bennowotny/ECE453_DumptruckUltra/ECE453_DumptruckUltra_Board/PCBFAB/README.txt

The board outline is defined by a 10 mil trace found on all gerbers.

The board is 4 in x 6 in.
