bennowotny/ECE453_DumptruckUltra/ECE453_DumptruckUltra_Board/Project Outputs for ECE453_DumptruckUltra_Board/ECE453_DumptruckUltra_Board.xlsx

Line # | Name | Description | Designator | Revision ID | Revision State | Revision Status | Quantity | Manufacturer 1 | Manufacturer Part Number 1 | Manufacturer Lifecycle 1 | Supplier 1 | Supplier Part Number 1 | Supplier Unit Price 1 | Supplier Subtotal 1 | Column1
 | 0.1uF | CAP CER 0.1UF 25V X7R 0805 | C1, C2, C5, C6, C9, C10, C17, C25, C40 |  | Unknown server |  | 9 | Kyocera AVX | 08053C104KAT2A | Volume Production | Digi-Key | 478-3755-1-ND | 0.061 | 0.61
 | 2.2uF | Cap Ceramic 2.2uF 35V X7R 10% Pad SMD 0805 +125°C Automotive T/R | C11, C12, C18 |  | Unknown server |  | 3 | TDK | CGA4J1X7R1V225K125AC | Volume Production | Digi-Key | 445-6963-1-ND | 0.42 | 1.26
 | 22uF | Chip Multilayer Ceramic Capacitors for General Purpose, 0805, 22uF, X5R, 15%, 20%, 25V | C13, C14, C15, C16, C19, C20 |  | Unknown server |  | 6 | Murata | GRM21BR61E226ME44L | Volume Production | Digi-Key | 490-10749-1-ND | 0.36 | 2.16
 | 1000uF | Aluminum Electrolytic Capacitor, UD Series, Low Impedance, 1000 uF, 10 V, + / - 20%, -55 to 105 degC, Chip Type, 10 x 10 mm D x L, Pb-Free, Reel | C21, C22, C23, C29, C30 |  | Unknown server |  | 5 | Nichicon | UUD1A102MNL1GS | Volume Production | Digi-Key | 493-2254-1-ND | 0.94 | 4.7
 | 6pF |  | C27, C28 |  | Unknown server |  | 2 | Kyocera AVX | 08055A6R0CAT2A | Volume Production | Digi-Key | 478-11894-1-ND | 0.24 | 0.48
 | 1uF |  | C3, C4, C7, C8, C26, C41 |  | Unknown server |  | 6 | Yageo | CC0805ZRY5V8BB105 | Volume Production | Digi-Key | 311-1358-1-ND | 0.13 | 0.78
 | BAR43CFILM | DIODE ARRAY SCHOTTKY 30V SOT23-3 | D1 |  | Unknown server |  | 1 | STMicroelectronics | BAR43CFILM | Volume Production | Digi-Key | 497-2520-1-ND | 0.42 | 0.42
 | HSMG-C170 | Chip LED, Green, 2.2 V, -40 to 85 degC, 2-Pin SMD, Pb-Free, Tape and Reel | DS1, DS2, DS3, DS4, DS5, DS6, DS7, DS8, DS9, DS10, DS11, DS12 |  | Unknown server |  | 12 | Broadcom Avago | HSMG-C170 | Volume Production | Digi-Key | 516-1434-1-ND | 0.251 | 3.01
 | 1729128 | PCB Terminal Block, 13.5 A, 400 V, 2-Pin THD, RoHS, Bulk | J1, J2 |  | Unknown server |  | 2 | Phoenix Contact | 1729128 | Volume Production | Digi-Key | 277-1247-ND | 1.17 | 2.34
 | KLDX-0202-A | DC Power Jack, 24 V, 3.5 A, -25 to 85 degC, 3-Pin THD, RoHS | J10 |  | Unknown server |  | 1 | Kycon | KLDX-0202-A | Volume Production | Digi-Key | 2092-KLDX-0202-A-ND | 0.74 | 0.74
 | PPTC052LFBN-RC | Receptacle, Pitch 2.54 mm, 2 x 5 Position, Height 8.5 mm, Tail Length 3.2 mm, -40 to 105 degC, RoHS | J11 |  | Unknown server |  | 1 | Sullins | PPTC052LFBN-RC | Volume Production | Digi-Key | S6105-ND | 0.69 | 0.69
 | ShuntHeader | Conn Mini Shunt 2 POS 2.54mm Black Cable Mount | J12, J14, J15, J16, J17, J18, J19, J20 |  | Not managed |  | 8 | Kycon | SX1100-B | Volume Production | Digi-Key | 2092-SX1100-B-ND | 0.06 | 0.6
 |  | Female, 6C, Rt Angle, .100"CC; 3.15mm Tail, No Mounting; PBT, Phos. Bronze, 105 C | J201 |  | Not managed |  | 1 | Sullins | PPPC061LGBN-RC | Volume Production | Digi-Key | S5481-ND | 0.66 | 0.66
 | 951103-8622-AR | CONN HEADER VERT 3POS 2MM | J3, J4, J5, J6, J7, J8, J9 |  | Unknown server |  | 7 | 3M | 951103-8622-AR | Volume Production | Digi-Key | 3M156413-03-ND | 0.3 | 2.1
 | 12uH | SDR0403 Series Power Inductor, 12 uF +/- 20 %, 0.21 Ohm, -40 to 125 degC, 2-Pin SMD, RoHS, Tape and Reel | L1 |  | Unknown server |  | 1 | Bourns | SDR0403-120ML | Volume Production | Digi-Key | SDR0403-120MLCT-ND | 0.62 | 0.62
 | 8.2uH | FIXED IND 8.2UH 2A 180 MOHM SMD | L2 |  | Unknown server |  | 1 | Bourns | SRP4020TA-8R2M | Volume Production | Digi-Key | SRP4020TA-8R2MCT-ND | 1.35 | 1.35
 | 10uH | SMD Inductors 10uH ±10% 0.15A 0.468O 0805 | L3 |  | Unknown server |  | 1 | Taiyo Yuden | LBR2012T100K | Not Recommended for New Design | Digi-Key | 587-2045-1-ND | 0.13 | 0.13
 | CYBLE-416045-02 | RF TXRX MOD BLUETOOTH TRACE ANT | MD1 |  | Unknown server |  | 1 | Cypress | CYBLE-416045-02
 | 61300211121 | THT Vertical Pin Header WR-PHD, Pitch 2.54 mm, Single Row, 2 pins | P1, P3, P4, P5, P6, P8, P9, P10, P11 |  | Unknown server |  | 9 | Wurth Electronics | 61300211121 | Volume Production | Digi-Key | 732-5315-ND | 0.113 | 1.13
 | 61300511121 | THT Vertical Pin Header WR-PHD, Pitch 2.54 mm, Single Row, 5 pins | P2 |  | Unknown server |  | 1 | Wurth Electronics | 61300511121 | Volume Production | Digi-Key | 732-5318-ND | 0.26 | 0.26
 | 61300611021 | THT Angled Pin Header WR-PHD, Pitch 2.54 mm, Single Row, 6 pins | P7 |  | Unknown server |  | 1 | Wurth Electronics | 61300611021 | Volume Production | Digi-Key | 732-5339-ND | 0.57 | 0.57
 | BSS138W-7-F | N-Channel Enhancement Mode Mosfet, 50 V, 200 mA, -55 to 150 degC, 6-Pin SOT-323, RoHS, Tape and Reel | Q1, Q2, Q3, Q4, Q5, Q6, Q7 |  | Unknown server |  | 7 | Diodes | BSS138W-7-F | Volume Production | Digi-Key | BSS138W-FDICT-ND | 0.31 | 2.17
 | FDC653N | MOSFET N-CH 30V 5A SSOT-6 | Q8 |  | Unknown server |  | 1 | ON Semiconductor / Fairchild | FDC653N | Volume Production | Digi-Key | FDC653NCT-ND | 0.66 | 0.66
 | 1k | RES 1K OHM 0.1% 1/8W 0805 | R1, R3 |  | Unknown server |  | 2 | Panasonic | ERA6AEB102V | Volume Production
 | 200k |  | R10 |  | Unknown server |  | 1 | Vishay | CRCW0805200KFKEA | Volume Production | Digi-Key | 541-200KCCT-ND | 0.1 | 0.1
 | 22.1k |  | R11, R18 |  | Unknown server |  | 2 | Panasonic | ERJ-6ENF2212V | Volume Production | Digi-Key | P22.1KCCT-ND | 0.1 | 0.2
 | 330, CRCW0805330RFKEA | RES Thick Film, 330O, 1%, 0.125W, 100ppm/°C, 0805 | R12, R13, R23, R24, R25, R29, R61, R65, R66, R67, R69 |  | Unknown server |  | 11 | Vishay | CRCW0805330RFKEA | Volume Production | Digi-Key, [NoParam] | 541-330CCT-ND, [NoParam]
 | 100k | RES 100K OHM 1% 1/8W 0805 | R16, R19 |  | Unknown server |  | 2 | Yageo | RC0805FR-07100KL | Volume Production | Digi-Key | 311-100KCRCT-ND | 0.1 | 0.2
 | ERJ-6GEYJ911V |  | R17 |  | Unknown server |  | 1 | Panasonic | ERJ-6GEYJ911V | Volume Production | Digi-Key | P910ACT-ND | 0.1 | 0.1
 | 10k | Chip Resistor, 10 KOhm, +/- 1%, 0.125 W, -55 to 155 degC, 0805 (2012 Metric), RoHS, Tape and Reel | R2, R4, R5, R6, R7, R8, R9, R14, R15, R28, R39, R58 |  | Unknown server |  | 12 | Yageo | RC0805FR-0710KL | Volume Production | Digi-Key | 311-10.0KCRCT-ND | 0.027 | 0.324
 | 330Ohms | Res Thick Film 0805 300O 5% 0.125W ±200ppm/°C Automotive Paper T/R | R20, R27, R57 |  | Unknown server |  | 3 | Rohm | KTR10EZPJ301 | Volume Production | Digi-Key | RHM300BCT-ND | 0.17 | 0.51
 | 13.7k | RES Thick Film, 13.7kO, 1%, 0.125W, 100ppm/°C, 0805 | R21 |  | Unknown server |  | 1 | Vishay | CRCW080513K7FKEA | Volume Production | Digi-Key | 541-13.7KCCT-ND | 0.1 | 0.1
 | CRCW0805110RFKEA |  | R22 |  | Unknown server |  | 1 | Vishay | CRCW0805110RFKEA | Volume Production | Digi-Key | 541-110CCT-ND | 0.1 | 0.1
 | 100Ohms | Chip Resistor, 100 Ohm, +/-1%, 0.125 W, -55 to 155 degC, 0805 (2012 Metric), RoHS, Tape and Reel | R30, R31, R32, R33, R34, R35, R36, R37, R38, R41, R42, R43, R44, R45, R46, R47, R48, R49, R50, R51, R52, R53, R54, R55, R56 |  | Unknown server |  | 25 | Yageo | RC0805FR-07100RL | Volume Production | Digi-Key | 311-100CRCT-ND | 0.025 | 0.625
 | 100k | RES 100K OHM 0.1% 1/8W 0805 | R40 |  | Unknown server |  | 1 | Panasonic | ERA-6AEB104V | Volume Production | Digi-Key | P100KDACT-ND | 0.36 | 0.36
 | 0 ohm | Chip Resistor, 0 Ohm, +/- 1%, 0.125 W, -55 to 155 degC, 0805 (2012 Metric), RoHS, Tape and Reel | R68, R70 |  | Unknown server |  | 2 | Panasonic | ERJ-6GEY0R00V | Volume Production | Digi-Key | P0.0ACT-ND | 0.1 | 0.2
 | 150141M173100 | SMD Full-Color Top LED, WL-SFTW, Red & Green & Blue | RGBLED0 |  | Unknown server |  | 1 | Wurth Electronics | 150141M173100 | Volume Production | Digi-Key | 732-4998-1-ND | 0.5 | 0.5
 | 1825910-6 | Tact Switch, SPST-NO, 0.05 A, -35 to 85 degC, 4-Pin THD, RoHS, Bulk | SW1, SW2 |  | Unknown server |  | 2 | TE Connectivity Alcoswitch | 1825910-6 | Volume Production | Digi-Key | 450-1650-ND | 0.13 | 0.26
 | 1101M2S3CQE2 | SWITCH SLIDE SPDT 6A 120V | SW3 |  | Unknown server |  | 1 | ITT C&K | 1101M2S3CQE2 | Volume Production | Digi-Key | CKN5001-ND | 4.21 | 4.21
 | 5019 | Test Point, 1 Position SMD, RoHS, Tape and Reel | TP1, TP2, TP3, TP4, TP5, TP6, TP7, TP8, TP9, TP10, TP11, TP12, TP13, TP14, TP15, TP16, TP17, TP18, TP19, TP20, TP21, TP22, TP23, TP24, TP25, TP26, TP27, TP28, TP29, TP30, TP31, TP32, TP33, TP34, TP35, TP36, TP37, TP40, TP41, TP42, TP43, TP45, TP46, TP47, TP48, TP49, TP50, TP51, TP52, TP53, TP54, TP59, TP60, TP61, TP62, TP63, TP64, TP65, TP66, TP68, TP69, TP70, TP71 |  | Unknown server |  | 63 | Keystone Electronics | 5019 | Volume Production | Digi-Key | 36-5019CT-ND | 0.2736 | 17.24
 | MotorDrivers | 35-V, 3.7-A H-bridge motor driver with integrated current regulation & current-sense feedback 8-SO PowerPAD -40 to 150 | U1, U2 |  | Not managed |  | 2 | Texas Instruments | DRV8231ADDAR | Volume Production | Digi-Key | 296-DRV8231ADDARCT-ND | 2 | 4
 | IMU_BREAKOUT |  | U10 |  | Not managed |  | 1 | Adafruit Industries | 4438 |  | Digi-Key | 1528-4438-ND | 11.95 | 11.95
 | SN74AHC1G08DBV3 | IC GATE AND 1CH 2-INP SOT23-5 | U11, U12 |  | Unknown server |  | 2 | Texas Instruments | SN74AHC1G08DBV3 | Volume Production | Digi-Key | 296-SN74AHC1G08DBV3CT-ND | 0.53 | 1.06
 | LMV796QMF/NOPB | 17 MHz, Low Noise, CMOS Input, 1.8V Operational Amplifier, Automotive Grade1, 5-pin SOT-23, Pb-Free | U14 |  | Unknown server |  | 1 | TI National Semiconductor | LMV796QMF/NOPB | Volume Production | Digi-Key | LMV796QMF/NOPBCT-ND | 2.14 | 2.14
 | LMR51420YDDCR | SIMPLE SWITCHER® power converter 4.5-V to 36-V, 2-A, synchronous buck with 40-µA IQ 6-SOT-23-THIN -40 to 150 | U3, U4, U5 |  | Not managed |  | 3 | Texas Instruments | LMR51420YDDCR | Volume Production | Digi-Key | 296-LMR51420YDDCRCT-ND | 1.56 | 4.68
 | TC54VN4502ECB713 | 1Î¼A Voltage Detector, Open-Drain Output, 4.5V, 3-Pin SOT-23A, Industrial Temperature, Tape and Reel | U6, U7 |  | Unknown server |  | 2 | Microchip | TC54VN4502ECB713 | Volume Production | Digi-Key | TC54VN4502ECB71CT-ND | 0.76 | 1.52
 | TC54VN2902ECB713 | 1Î¼A Voltage Detector, Open-Drain Output, 2.9V, 3-Pin SOT-23A, Industrial Temperature, Tape and Reel | U8 |  | Unknown server |  | 1 | Microchip | TC54VN2902ECB713 | Volume Production | Digi-Key | TC54VN2902ECB71CT-ND | 0.68 | 0.68
 | XT60 | XT60 Connectors Male/female Pair | U9 |  | Not managed |  | 1 | SparkFun | PRT-10474 | Volume Production | Mouser | 474-PRT-10474 | 1.5 | 1.5
 | 32.768KHZ | CRYSTAL 32.7680KHZ 6PF SMD | Y1 |  | Unknown server |  | 1 | Abracon | ABS07-120-32.768KHZ-T | Volume Production | Digi-Key | 535-11937-1-ND | 0.84 | 0.84
