bennowotny/ECE453_DumptruckUltra/ECE453_DumptruckUltra_Board/ECE453_DumptruckUltra_Board.pdf

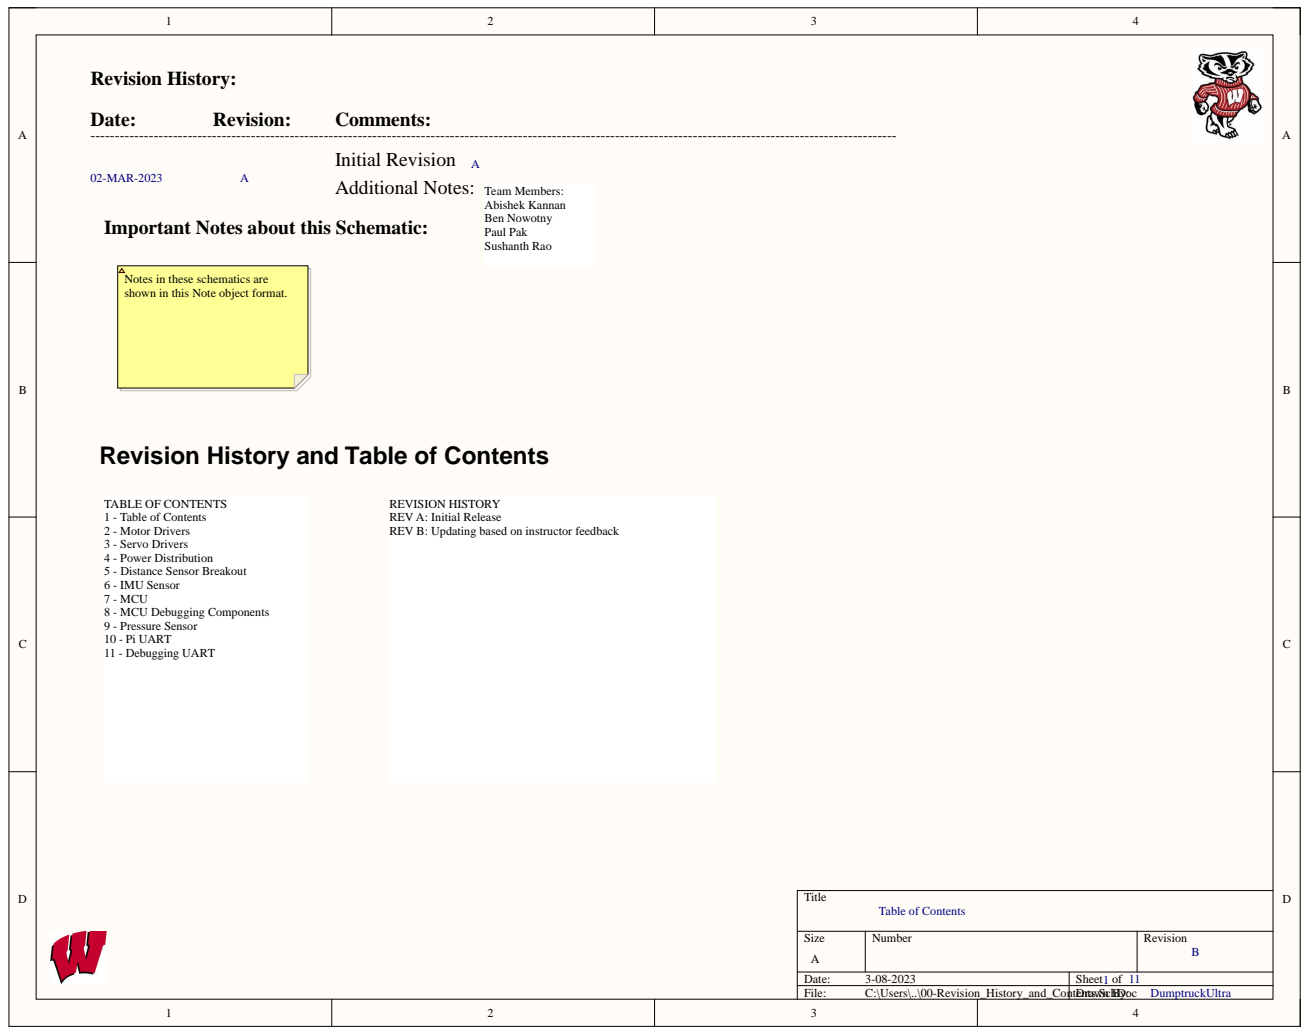
[picture p1: page 1]

Important Notes about this Schematic:

Notes in these schematics are
shown in this Note object format.

Revision History and Table of Contents

REVISION HISTORY
REV A: Initial Release
REV B: Updating based on instructor feedback

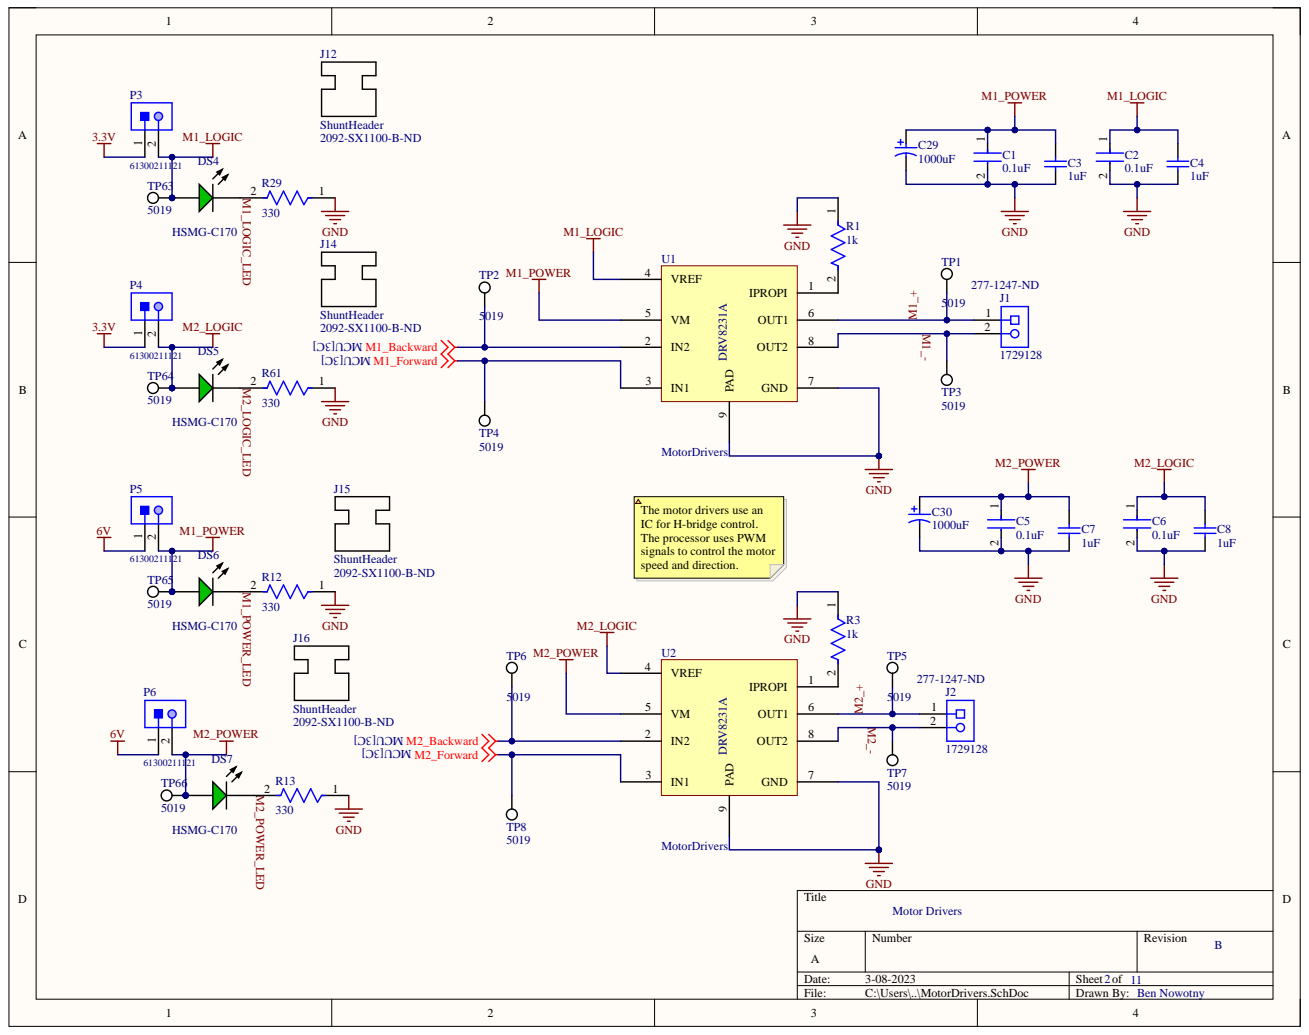
[picture p2: page 2]

The motor drivers use an
IC for H-bridge control.
The processor uses PWM
signals to control the motor
speed and direction.

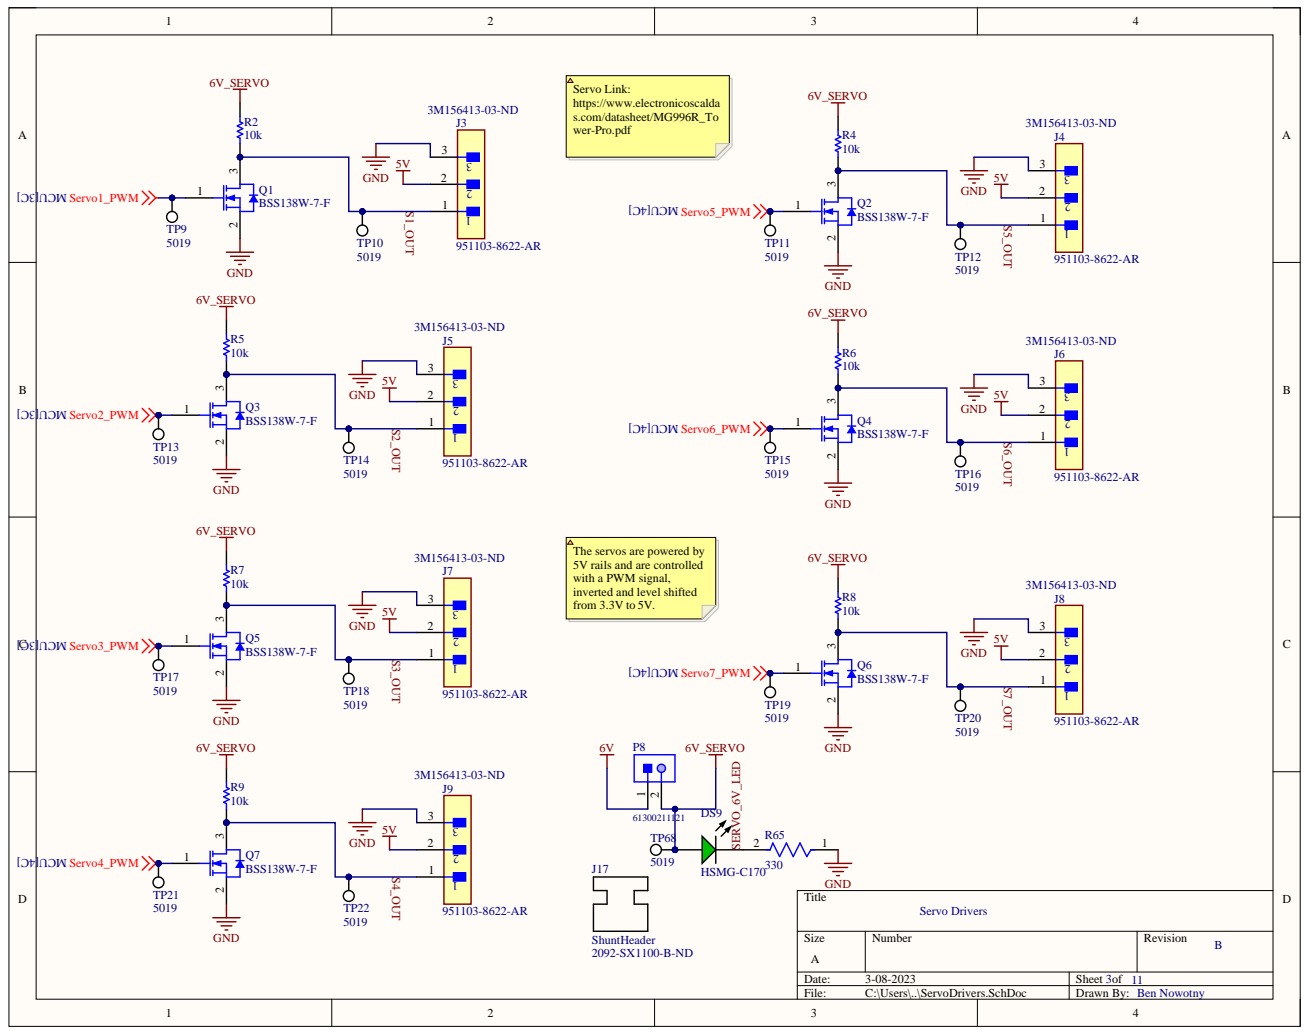
[picture p3: page 3]

The servos are powered by
5V rails and are controlled
with a PWM signal,
inverted and level shifted
from 3.3V to 5V

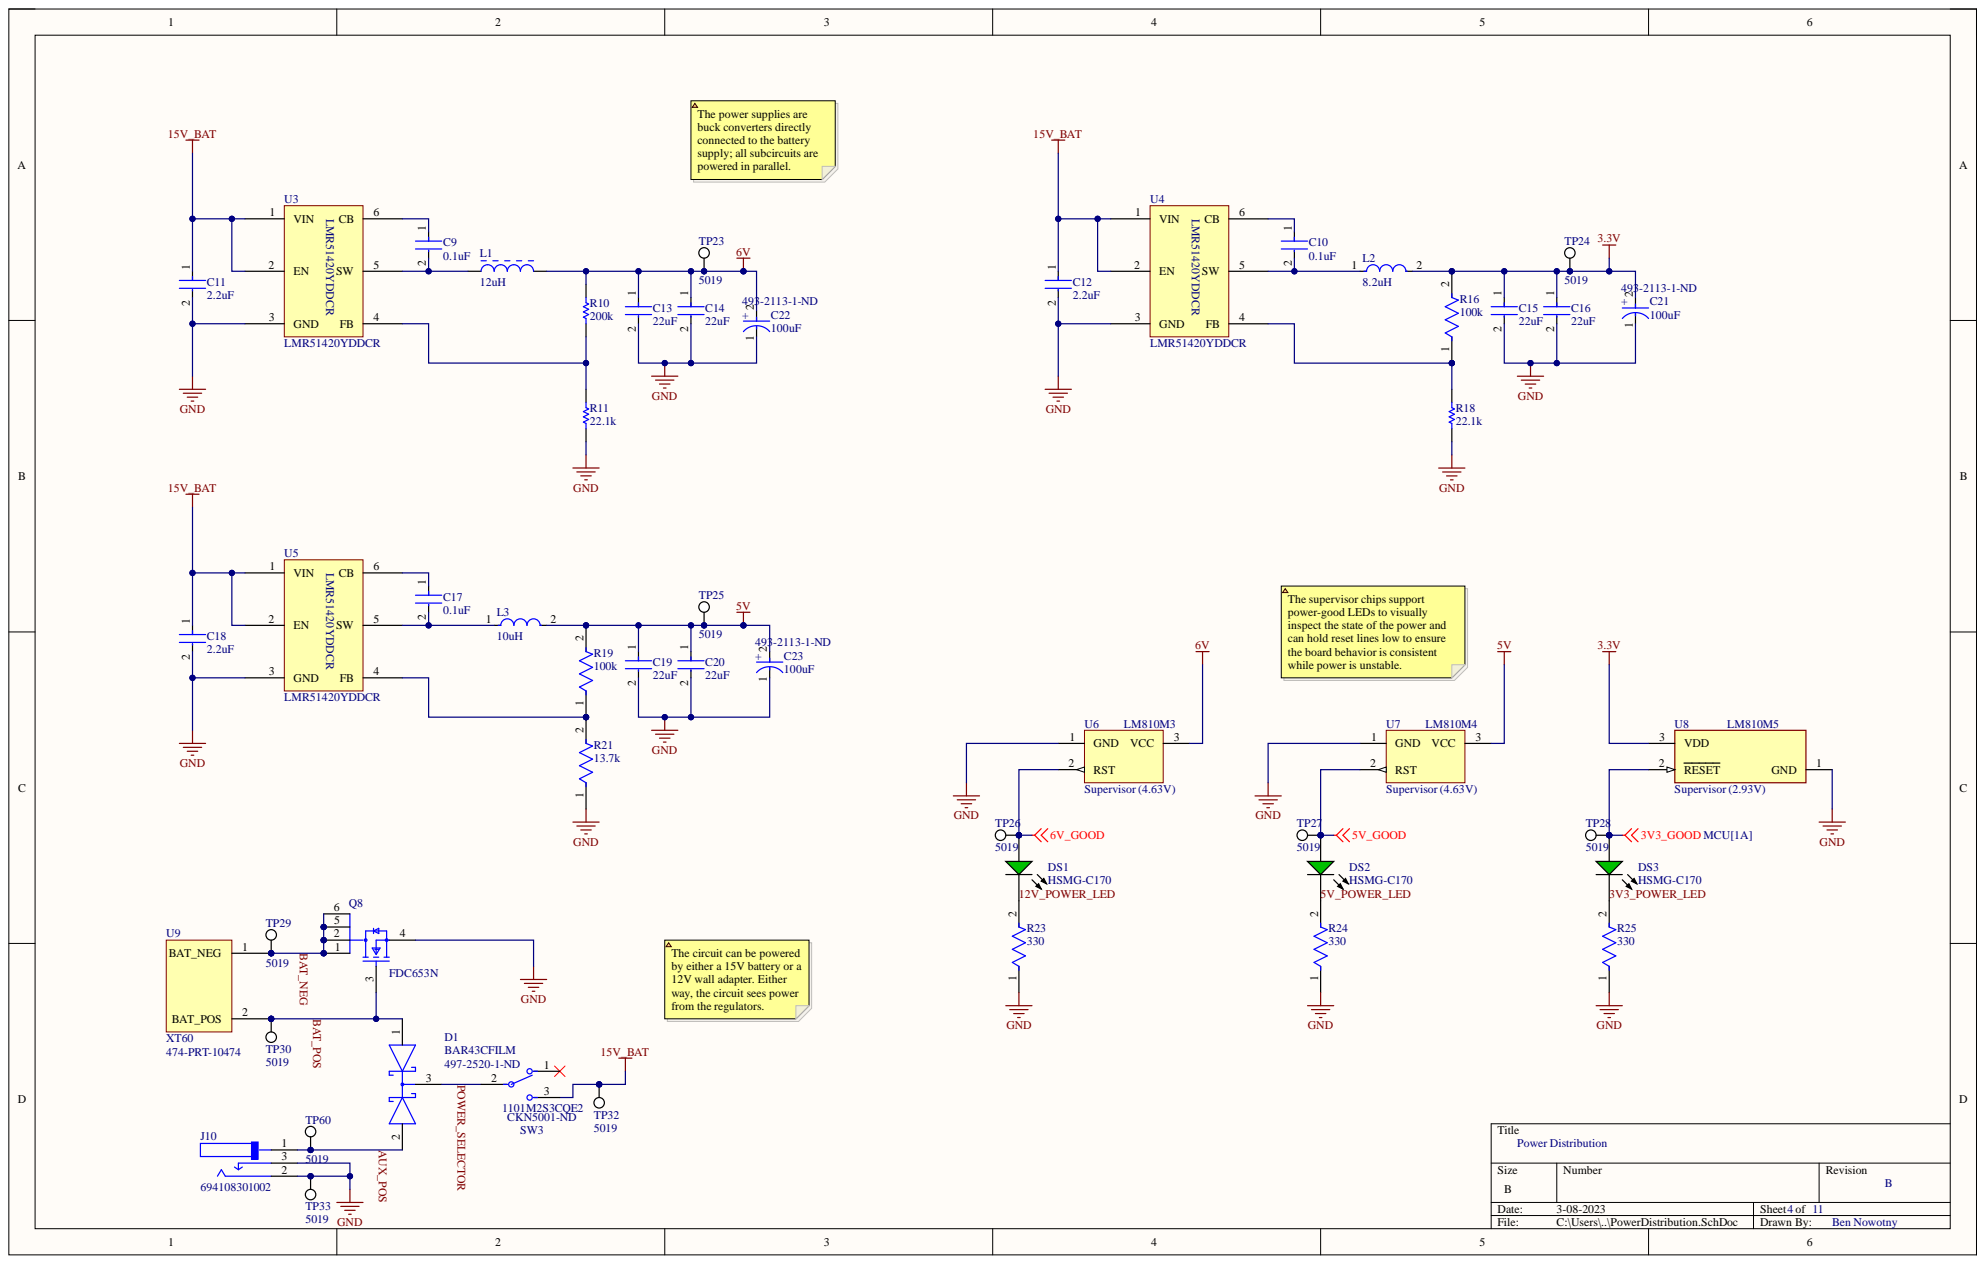
[picture p4: page 4]

The power supplies are
buck converters directly
connected to the battery
supply; all subcircuits are
powered in parallel.

The supervisor chips support
power-good LEDs to visually
inspect the state of the power and
can hold reset lines low to ensure
the board behavior is consistent
while power is unstable.

The circuit can be powered
by either a 15V battery or a
12V wall adapter. Either
way, the circuit sees power
from the regulators.

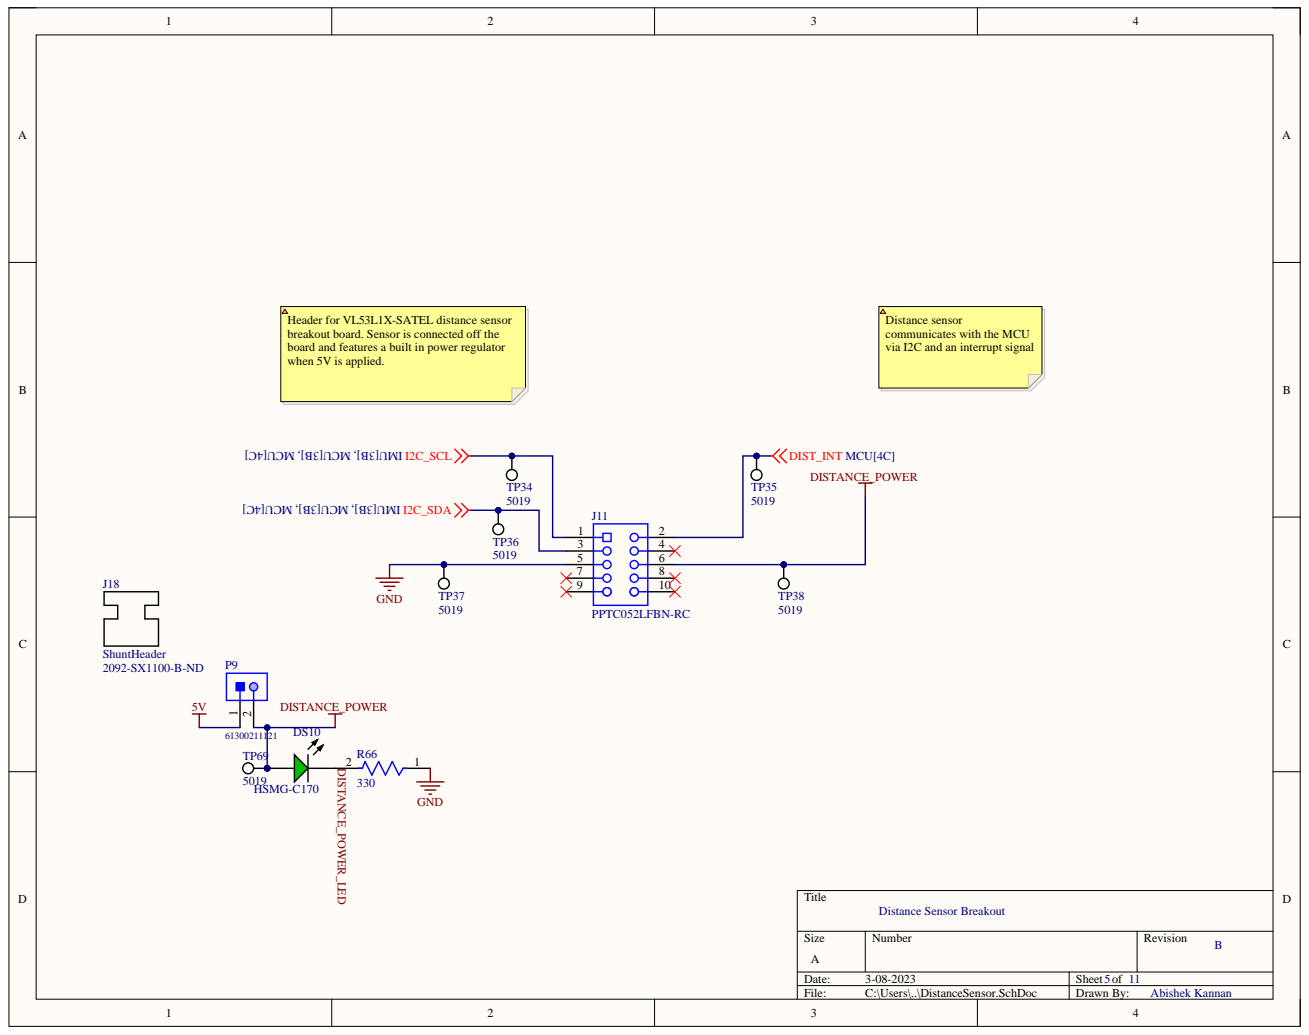
[picture p5: page 5]

Header for VL53L1X-SATEL distance sensor
breakout board. Sensor is connected off the
board and features a built in power regulator
when 5V is applied.

Distance sensor
communicates with the MCU
via I2C and an interrupt signal

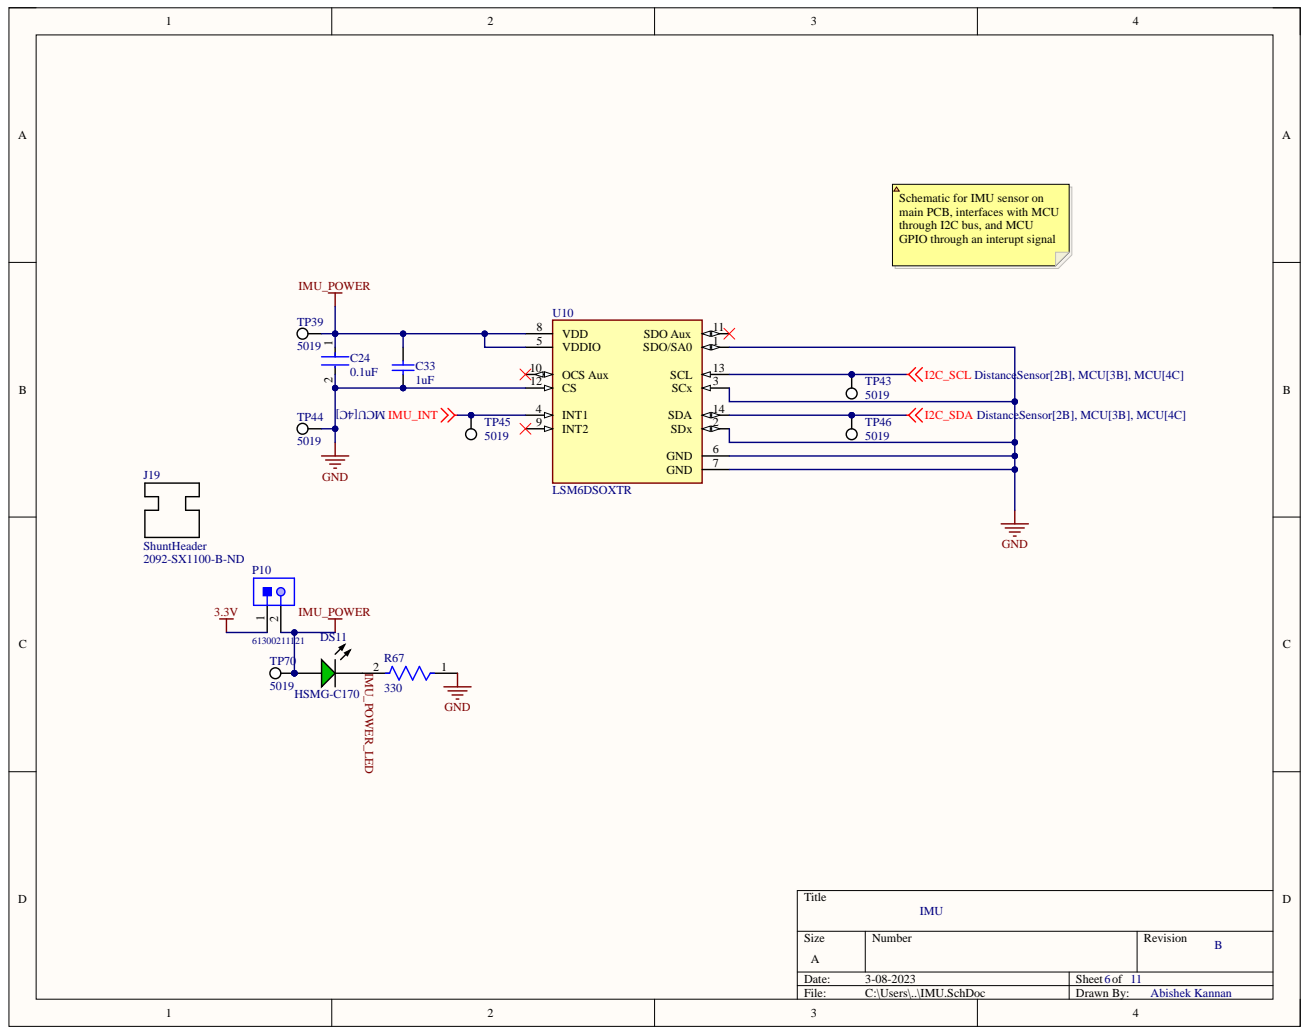
[picture p6: page 6]

Schematic for IMU sensor on
main PCB, interfaces with MCU
through I2C bus, and MCU
GPIO through an interupt signal

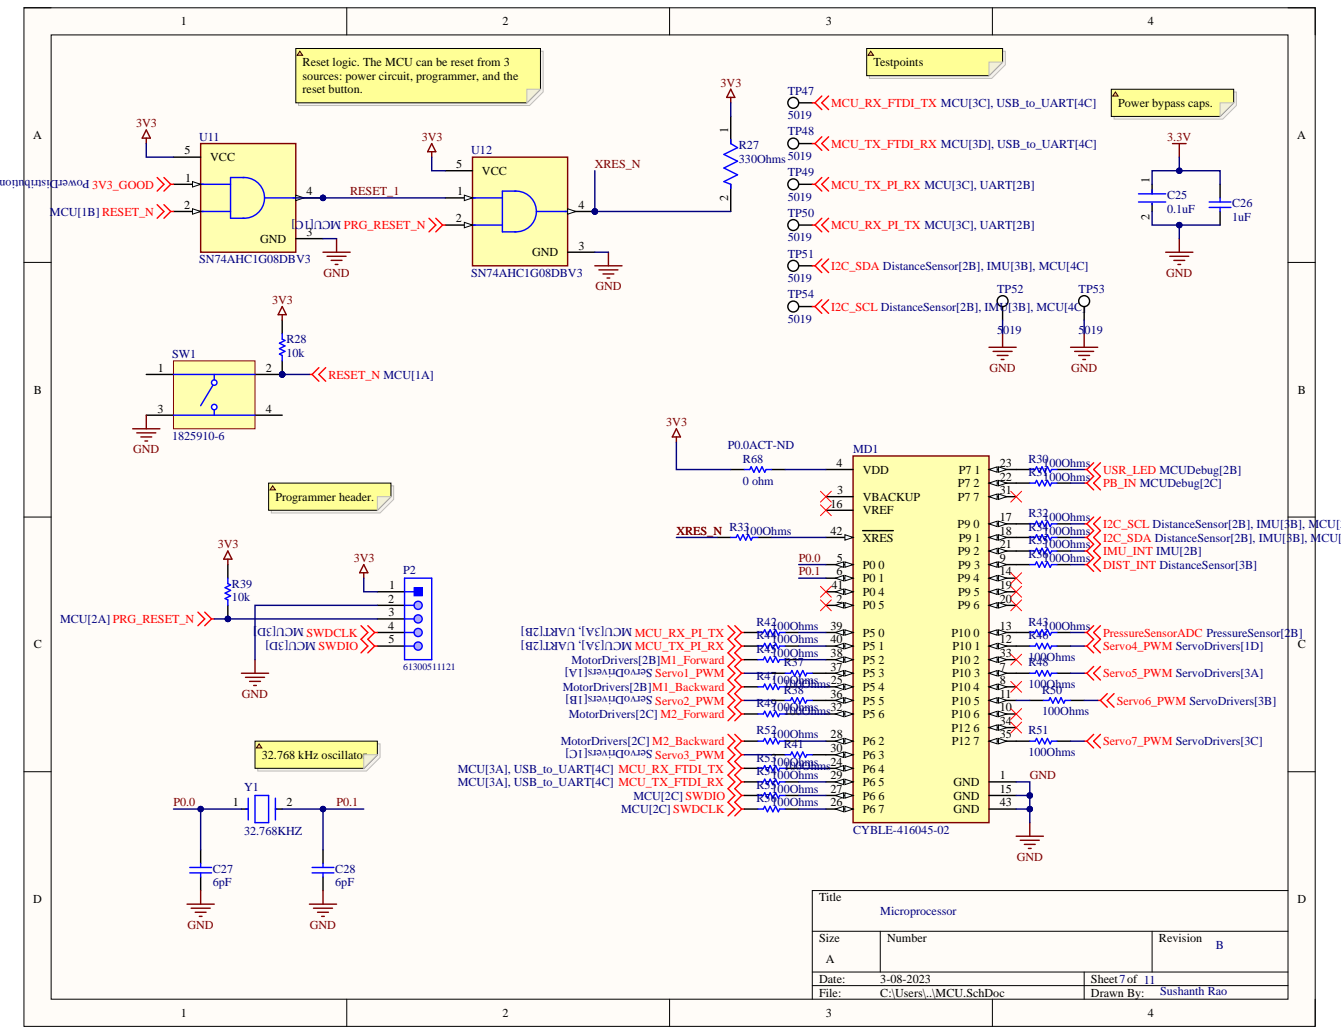
[picture p7: page 7]

Reset logic. The MCU can be reset from 3
sources: power circuit, programmer, and the
reset button.

3V3_GOOD ] C5[ noit ubirtsi Dr e woP

MotorDrivers[2B]M1_Forward
Servo1_PWM ] A1[sr evir Dovr eS
MotorDrivers[2B]M1_Backward
Servo2_PWM ] B1[sr evir Dovr eS
MotorDrivers[2C] M2_Forward

MotorDrivers[2C] M2_Backward
Servo3_PWM ] C1[sr evir Dovr eS

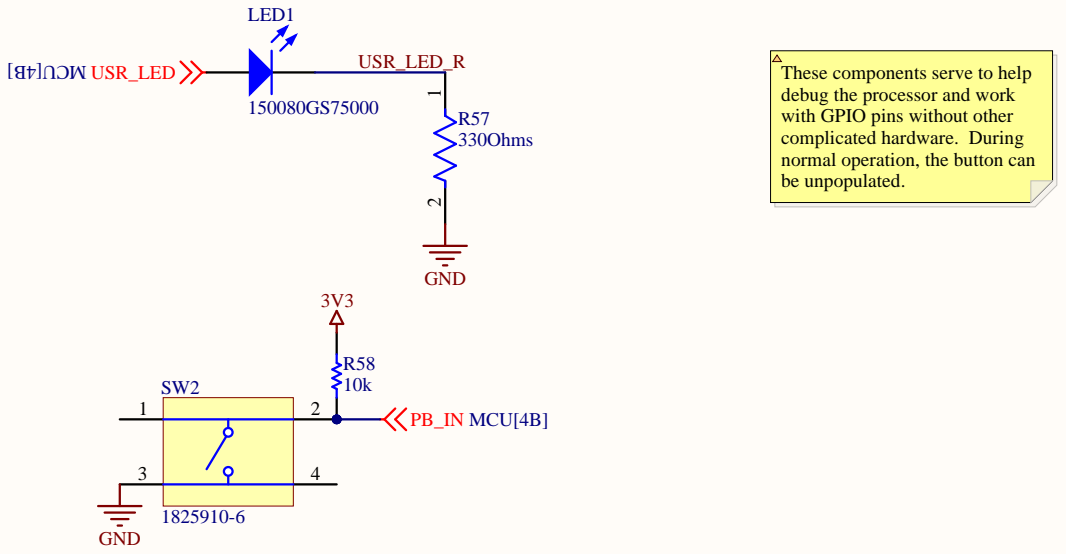
[picture p8: page 8]

These components serve to help
debug the processor and work
with GPIO pins without other
complicated hardware. During
normal operation, the button can
be unpopulated.

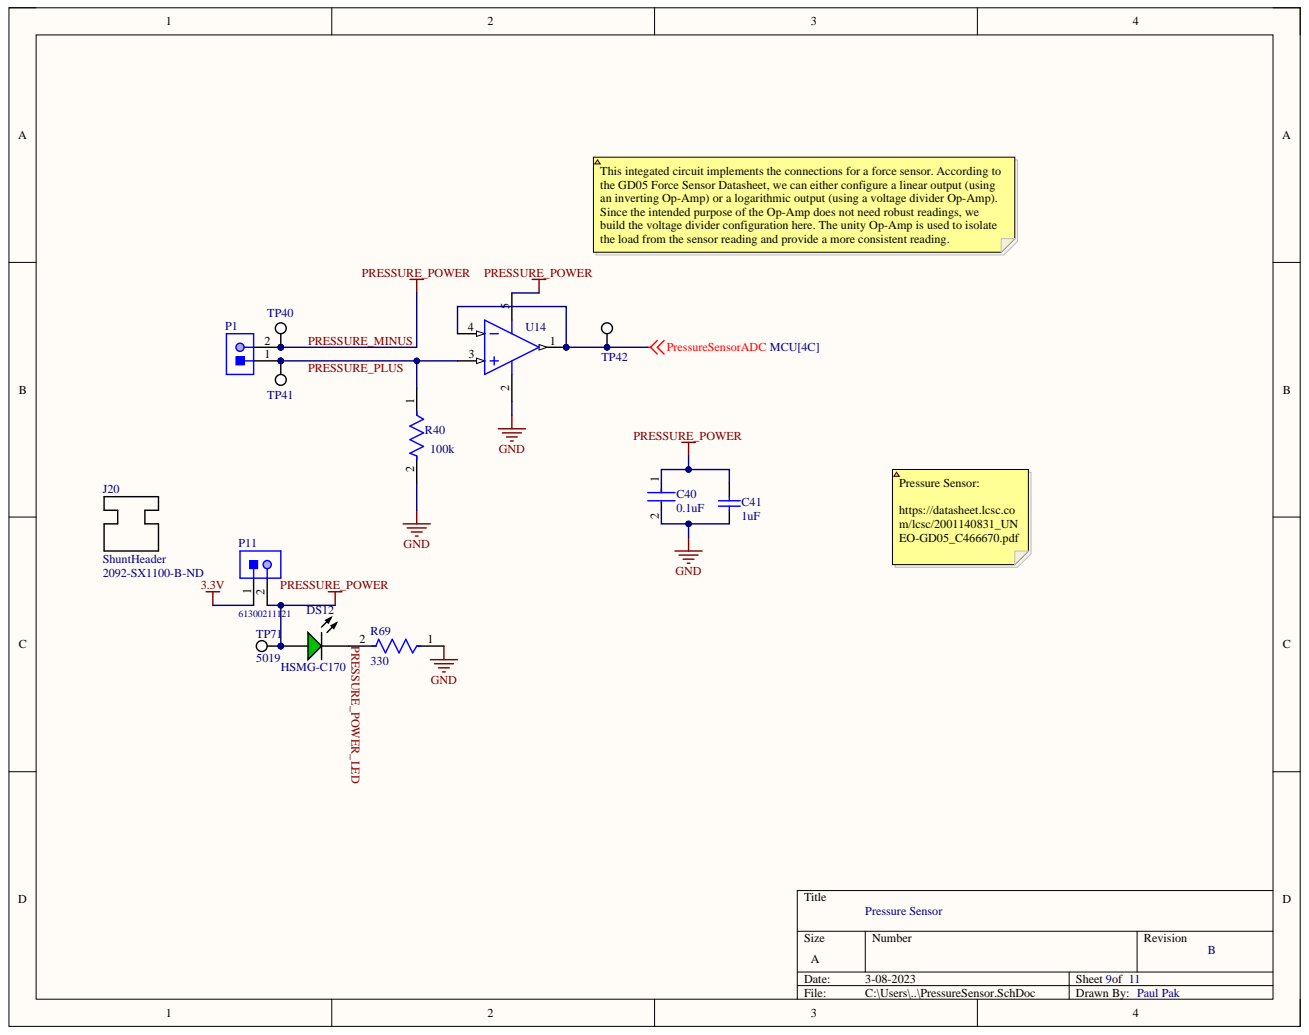
[picture p9: page 9]

This integated circuit implements the connections for a force sensor. According to
the GD05 Force Sensor Datasheet, we can either configure a linear output (using
an inverting Op-Amp) or a logarithmic output (using a voltage divider Op-Amp).
Since the intended purpose of the Op-Amp does not need robust readings, we
build the voltage divider configuration here. The unity Op-Amp is used to isolate
the load from the sensor reading and provide a more consistent reading.

https://datasheet.lcsc.co
m/lcsc/2001140831_UN
EO-GD05_C466670.pdf

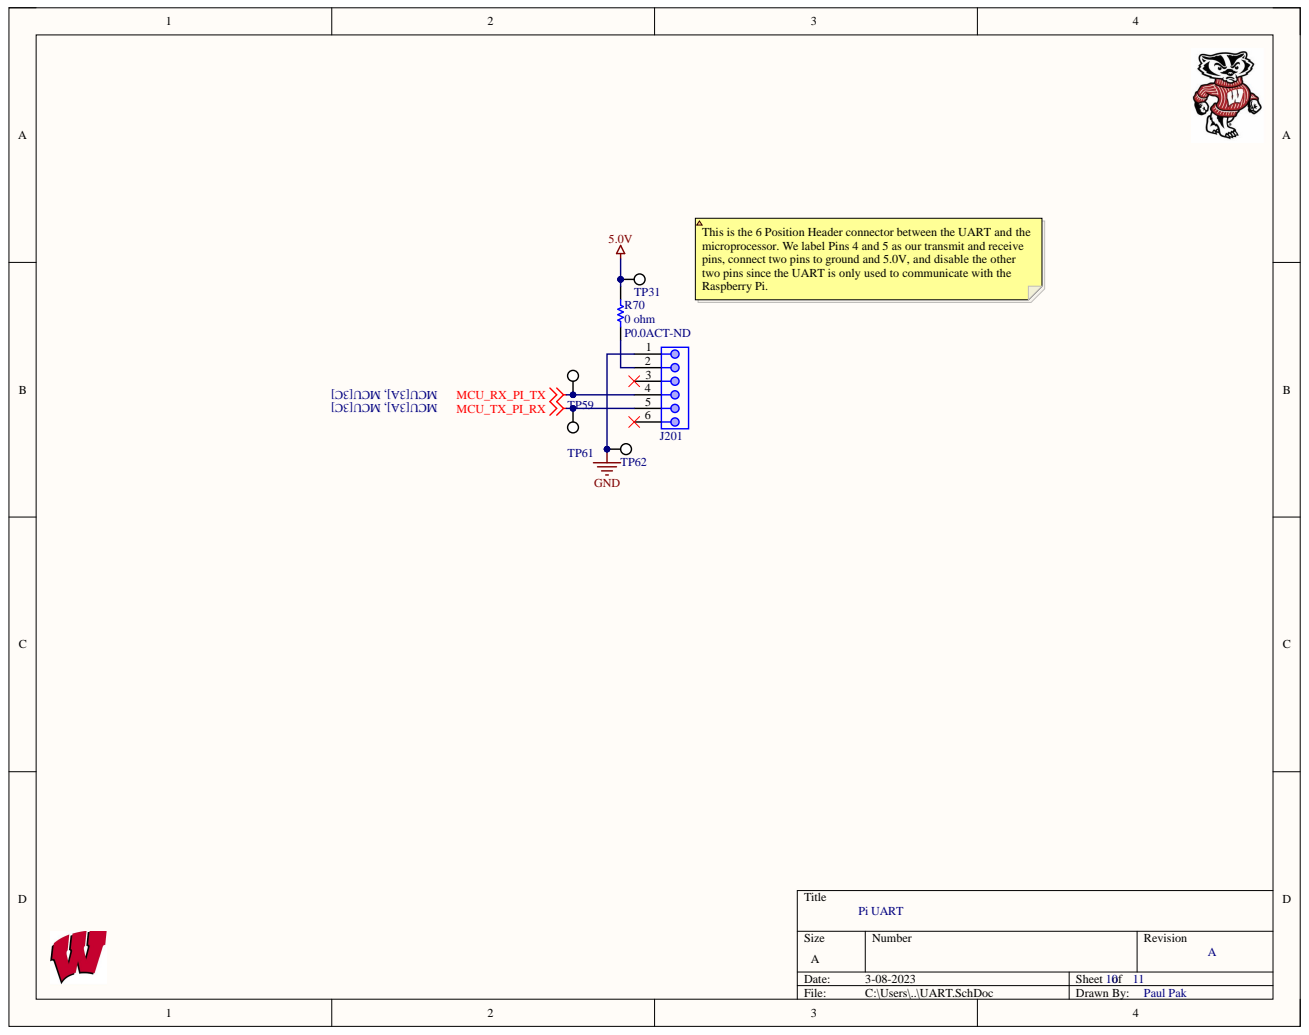
[picture p10: page 10]

This is the 6 Position Header connector between the UART and the
microprocessor. We label Pins 4 and 5 as our transmit and receive
pins, connect two pins to ground and 5.0V, and disable the other
two pins since the UART is only used to communicate with the
Raspberry Pi.

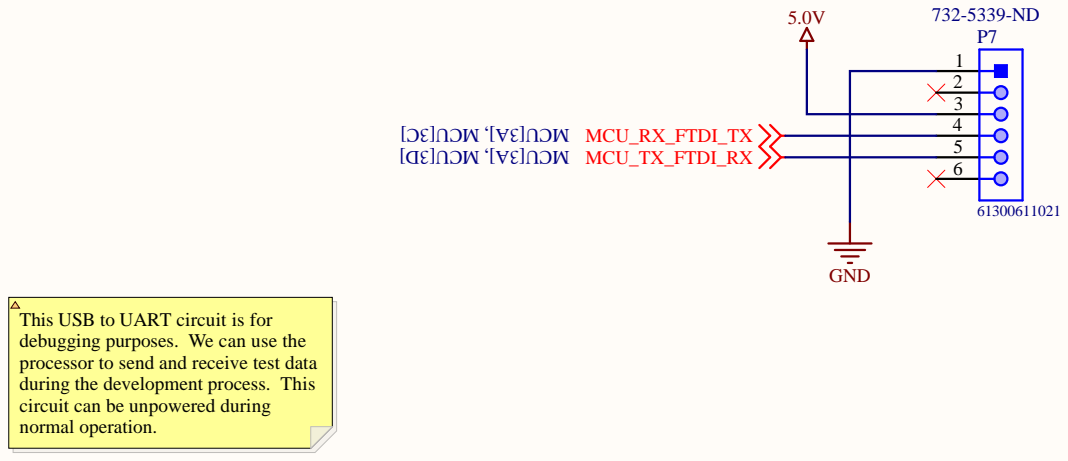
[picture p11: page 11]

This USB to UART circuit is for
debugging purposes. We can use the
processor to send and receive test data
during the development process. This
circuit can be unpowered during
normal operation.

USB to UART - DEBUG
