bennowotny/ECE453_DumptruckUltra/(list of files, drawings)

Other design files:
ECE453_DumptruckUltra_Board/00-Revision_History_and_Contents.SchDoc
ECE453_DumptruckUltra_Board/CustomFootprints.PcbLib
ECE453_DumptruckUltra_Board/CustomSchematics.SchLib
ECE453_DumptruckUltra_Board/DispenserSystem.SchDoc
ECE453_DumptruckUltra_Board/DistanceSensor.SchDoc
ECE453_DumptruckUltra_Board/ECE453_DumptruckUltra_Board.PrjPcb
ECE453_DumptruckUltra_Board/IMU.SchDoc
ECE453_DumptruckUltra_Board/MainBoard.PcbDoc
ECE453_DumptruckUltra_Board/MCU.SchDoc
ECE453_DumptruckUltra_Board/MCUDebug.SchDoc
ECE453_DumptruckUltra_Board/MotorDrivers.SchDoc
ECE453_DumptruckUltra_Board/PowerDistribution.SchDoc
ECE453_DumptruckUltra_Board/PressureSensor.SchDoc
ECE453_DumptruckUltra_Board/ServoDrivers.SchDoc
ECE453_DumptruckUltra_Board/UART.SchDoc
ECE453_DumptruckUltra_Board/USB_to_UART.SchDoc
