bennowotny/ECE453_DumptruckUltra/Software/DumptruckUltra-MCU/hw/motors/Motor.hpp

#ifndef HW_MOTORS_MOTOR_HPP_
#define HW_MOTORS_MOTOR_HPP_

#include "cyhal_hw_types.h"

namespace Hardware {
namespace Motors {

enum class MotorDirection {
    FORWARD,
    REVERSE
};

struct MotorPinDefinition {
    cyhal_gpio_t forwardPin;
    cyhal_gpio_t backwardPin;
};

class Motor {
public:
    explicit Motor(MotorPinDefinition motorPins, MotorDirection positiveDirection);
    void enable();
    void disable();
    void setPower(float power);
    [[nodiscard]] auto getPower() const -> float;

    static constexpr float MOTOR_MAX_SPEED_ABS{100};

private:
    cyhal_pwm_t forwardPWMHandle;
    cyhal_pwm_t backwardPWMHandle;
    float currentPower;
    const MotorDirection positiveDirection;

    // A guess.
    // There shouldn't be any protocol specific requirements for the frequency of an H-bridge (maybe upper limit for max switching frequency).
    // Just controls how much resolution we have in the power delivered.
    static constexpr uint32_t MOTOR_PWM_FREQUENCY_HZ{500};
};

} // namespace Motors
} // namespace Hardware

#endif
