bennowotny/ECE453_DumptruckUltra/Software/DumptruckUltra-MCU/logic/fsm/fsmStates.hpp

#pragma once

#include "DumptruckUltra.hpp"
#include "dispenser/Dispenser.hpp"
#include "driving-algorithm/DrivingAlgorithm.hpp"
#include "logic/arm-inverse-kinematics/ArmControl.hpp"
#include "vision/ObjectDetector.hpp"

namespace Logic {
namespace FSM {

auto initStateAction(const std::function<void()> &setup) -> DumptruckUltra::FSMState;
auto driveToSearchAction(Logic::DrivingAlgorithm::DrivingAlgorithm &drivingAlg) -> DumptruckUltra::FSMState;
auto localSearchAction(const std::function<void(Logic::DrivingAlgorithm::MotorSpeeds)> &motorControl, Logic::Vision::ObjectDetector &vision) -> DumptruckUltra::FSMState;
auto approachAction(Logic::DrivingAlgorithm::DrivingAlgorithm &drivingAlg, Logic::Vision::ObjectDetector &vision) -> DumptruckUltra::FSMState;
auto pickupAction(Logic::Arm::ArmControl &arm, Logic::Vision::ObjectDetector &vision, Logic::DeadReckoning::DeadReckoning &deadReckoning, Logic::Dispenser::Dispenser &dispenser) -> DumptruckUltra::FSMState;
auto driveToStartAction(Logic::DrivingAlgorithm::DrivingAlgorithm &drivingAlg) -> DumptruckUltra::FSMState;
auto dispenseAction(Logic::Dispenser::Dispenser &dispenser) -> DumptruckUltra::FSMState;

} // namespace FSM
} // namespace Logic
