bennowotny/ECE453_DumptruckUltra/Software/DumptruckUltra-MCU/logic/dispenser/Dispenser.cpp

#include "Dispenser.hpp"
#include "cyhal_system.h"

namespace Logic {
namespace Dispenser {
Dispenser::Dispenser(Hardware::Servos::Servo dispenserServo)
    : dispenserServo{dispenserServo},
      objectCount{0} {
    close();
}

void Dispenser::open() {
    dispenserServo.enable();
    dispenserServo.setPosition(OPEN_POSITION);
}

void Dispenser::close() {
    dispenserServo.setPosition(CLOSE_POSITION);
    cyhal_system_delay_ms(500);
    dispenserServo.disable();
}

void Dispenser::placeObject() {
    ++objectCount;
}

[[nodiscard]] auto Dispenser::getNumObjects() const -> uint32_t {
    return objectCount;
}

[[nodiscard]] auto Dispenser::full() const -> bool {
    return getNumObjects() >= MAX_OBJECTS;
}

void Dispenser::clear() {
    objectCount = 0;
}

} // namespace Dispenser
} // namespace Logic
