bennowotny/ECE453_DumptruckUltra/Software/DumptruckUltra-MCU/hw/i2c/i2cBusManager.cpp

/*
 * i2cBusManager.cpp
 *
 *  Created on: Mar 27, 2023
 *      Author: surao
 */
#include "i2cBusManager.hpp"

namespace Hardware {
namespace I2C {

I2CBusManager::I2CBusManager(const i2cPin_t &i2cPins) {
    cy_rslt_t rslt = i2cInit(i2cPins);
    CY_ASSERT(rslt == CY_RSLT_SUCCESS);

    // Create mutex
    mutex = xSemaphoreCreateMutex();
}

/** Initialize the I2C bus to the specified module site
 *
 * @param - None
 */
cy_rslt_t I2CBusManager::i2cInit(const i2cPin_t &i2cPins) {
    // Define I2C monarch config
    cyhal_i2c_cfg_t i2cMonarchConfig =
        {
            CYHAL_I2C_MODE_MASTER,
            0, // address is not used for master mode
            I2C_MASTER_FREQUENCY_HZ};

    // Initialize I2C monarch, set the SDA and SCL pins and assign a new clock
    cy_rslt_t rslt = cyhal_i2c_init(&i2cMonarchObj, i2cPins.sda, i2cPins.scl, nullptr);
    CY_ASSERT(rslt == CY_RSLT_SUCCESS);

    // Configure the I2C resource to be monarch
    rslt = cyhal_i2c_configure(&i2cMonarchObj, &i2cMonarchConfig);
    CY_ASSERT(rslt == CY_RSLT_SUCCESS);
    return rslt;
}

} // namespace I2C
} // namespace Hardware
