bennowotny/ECE453_DumptruckUltra/Software/DumptruckUltra-MCU/logic/dead-reckoning/Positioning.hpp

#ifndef LOGIC_DEAD_RECKONING_POSITIONING
#define LOGIC_DEAD_RECKONING_POSITIONING

namespace Logic {
namespace DeadReckoning {
struct Pose2D {
    float x;
    float y;
    float heading;
};
} // namespace DeadReckoning
} // namespace Logic

#endif
