bennowotny/ECE453_DumptruckUltra/Software/DumptruckUltra-MCU/hw/pressure_sensor/test/test_pressure_sensor.cpp

#include "cy_retarget_io.h"
#include "cyhal_psoc6_01_43_smt.h"
#include "hw/pressure_sensor/pressure_sensor.hpp"
#include "proc_setup.hpp"

using namespace std;

int main() {
    Hardware::Processor::setupProcessor();

    using Hardware::PressureSensor::PressureSensor;

    cy_retarget_io_init(P6_5, P6_4, 9600);

    // Setup ADC
    PressureSensor adc(P10_0);
    // printf("ADC Reading: %ld\r\n", adc.read());

    while (true) {
        printf("ADC Reading: %ld\r\n", adc.read());
        cyhal_system_delay_ms(500);
    }
}
