bennowotny/ECE453_DumptruckUltra/Software/DumptruckUltra-MCU/logic/dead-reckoning/test/test_IntegrationWithIMU.cpp

#include "DeadReckoning.hpp"
#include "DrivingAlgorithm.hpp"
#include "FreeRTOSConfig.h"
#include "cy_retarget_io.h"
#include "cy_utils.h"
#include "cyhal_gpio.h"
#include "cyhal_gpio_impl.h"
#include "cyhal_psoc6_01_43_smt.h"
#include "cyhal_system.h"
#include "i2cBusManager.hpp"
#include "imu.hpp"
#include "proc_setup.hpp"
#include "projdefs.h"
#include "task.h"
#include <memory>

auto printStr(const char *str) {
    printf("%s", str);
}

auto main() -> int {
    using Hardware::I2C::I2CBusManager;
    using Hardware::IMU::IMU;
    using Logic::DeadReckoning::DeadReckoning;

    Hardware::I2C::i2cPin_t i2cPins{.sda = Hardware::Processor::I2C_SDA, .scl = Hardware::Processor::I2C_SCL};
    auto i2cBus{std::make_shared<I2CBusManager>(i2cPins)};

    auto uut{std::make_unique<DeadReckoning>()};
    uut->setMotorSpeedsHandle([]() -> Logic::DrivingAlgorithm::MotorSpeeds { return {0.1, 0}; });

    auto imu{std::make_unique<IMU>(
        i2cBus,
        [uu2{uut.get()}](const Hardware::IMU::AccelerometerData &msg) -> void { uu2->sendAccelerometerMessage(msg); },
        [uut2{uut.get()}](const Hardware::IMU::GyroscopeData &msg) -> void { uut2->sendGyroscopeMessage(msg); },
        printStr)};

    cy_retarget_io_init(Hardware::Processor::MCU_TX_FTDI_RX, Hardware::Processor::MCU_RX_FTDI_TX, 115200);

    cyhal_gpio_init(P10_3, CYHAL_GPIO_DIR_OUTPUT, CYHAL_GPIO_DRIVE_STRONG, false);

    // Create task which runs DeadReckoning
    xTaskCreate(
        [](void *params) -> void {
            Logic::DeadReckoning::DeadReckoning *uut{static_cast<DeadReckoning *>(params)};
            while (true) {
                vTaskDelay(pdMS_TO_TICKS(500));
                Logic::DeadReckoning::Pose2D currPose = uut->getCurrentPose();
                // (void)currPose;
                // cyhal_gpio_write(P10_3, true);
                printf("%0.2f %0.2f %0.2f\r\n", currPose.x, currPose.y, currPose.heading);
                // cyhal_gpio_write(P10_3, false);
            }
        },
        "dead_reckoning",
        4 * configMINIMAL_STACK_SIZE,
        (void *)uut.get(),
        tskIDLE_PRIORITY + 2,
        nullptr);

    xTaskCreate(
        [](void *params) -> void {
            while (true) {
            }
        },
        "spin",
        configMINIMAL_STACK_SIZE,
        nullptr,
        tskIDLE_PRIORITY + 1,
        nullptr);

    vTaskStartScheduler();

    CY_ASSERT(0); // Should never reach here
}
