bennowotny/ECE453_DumptruckUltra/(commit log)

2023-02-17 Adding motor driver schematics
    [Sheet1.SchDoc]
2023-02-20 Updates to routing
    [PCB1.PcbDoc, Sheet1.SchDoc]
2023-02-20 Changed sheet name
    [MotorDrivers.SchDoc, Sheet1.SchDoc]
2023-02-20 Renamed main board
    [MainBoard.PcbDoc, PCB1.PcbDoc]
2023-02-20 Attempting to route
    [ECE453_DumptruckUltra_Board.PrjPcb, MainBoard.PcbDoc, MotorDrivers.SchDoc]
2023-02-23 Finishing motor routing
    [ECE453_DumptruckUltra_Board.PrjPcb, MainBoard.PcbDoc, MotorDrivers.SchDoc]
2023-02-23 Starting servo design
    [ECE453_DumptruckUltra_Board.PrjPcb, ServoDrivers.SchDoc]
2023-02-24 adding copies of servo circuits
    [ECE453_DumptruckUltra_Board.PrjPcb, ServoDrivers.SchDoc]
2023-02-24 Added DispenserSystem and MCU schematics
    [DispenserSystem.SchDoc, MCU.SchDoc]
2023-02-24 finishing routing for servos
    [ECE453_DumptruckUltra_Board.PrjPcb, MainBoard.PcbDoc, ServoDrivers.SchDoc]
2023-02-24 Starting power distribution designs
    [ECE453_DumptruckUltra_Board.PrjPcb, PowerDistribution.SchDoc]
2023-02-27 initial schematics done
    [CustomFootprints.PcbLib, CustomSchematics.SchLib, ECE453_DumptruckUltra_Board.PrjPcb, MainBoard.PcbDoc, PowerDistribution.SchDoc]
2023-03-01 Adding XT60 footprint
    [CustomFootprints.PcbLib]
2023-03-01 Updating schematics
    [CustomFootprints.PcbLib, CustomSchematics.SchLib, PowerDistribution.SchDoc, ServoDrivers.SchDoc]
2023-03-01 Finishing schematics
    [MotorDrivers.SchDoc, PowerDistribution.SchDoc, ServoDrivers.SchDoc]
2023-03-01 fixing errors
    [DistanceSensor.SchDoc, IMU.SchDoc, MCU.SchDoc, MCUDebug.SchDoc, PowerDistribution.SchDoc, PressureSensor.SchDoc, UART.SchDoc, USB_to_UART.SchDoc]
2023-03-02 almost ready to submit
    [DistanceSensor.SchDoc, ECE453_DumptruckUltra_Board.PrjPcb, IMU.SchDoc, MCU.SchDoc, MCUDebug.SchDoc, MotorDrivers.SchDoc, PowerDistribution.SchDoc, PressureSensor.SchDoc]
2023-03-03 Adding history doc
    [00-Revision_History_and_Contents.SchDoc]
2023-03-06 Updates to schematics
    [CustomFootprints.PcbLib, CustomSchematics.SchLib, DistanceSensor.SchDoc, IMU.SchDoc, MotorDrivers.SchDoc, PowerDistribution.SchDoc, PressureSensor.SchDoc, ServoDrivers.SchDoc]
2023-03-06 Updated Servo pin connections and all other affected pins
    [MCU.SchDoc]
2023-03-07 Reannotated schematics with updates
    [MotorDrivers.SchDoc, PressureSensor.SchDoc, ServoDrivers.SchDoc]
2023-03-07 Finished annotation updates and validated design
    [DistanceSensor.SchDoc, IMU.SchDoc, MotorDrivers.SchDoc]
2023-03-08 Fixing BOM
    [CustomFootprints.PcbLib, CustomSchematics.SchLib, MCU.SchDoc, MotorDrivers.SchDoc, PowerDistribution.SchDoc]
2023-03-08 Updating final revision
    [00-Revision_History_and_Contents.SchDoc, DistanceSensor.SchDoc, ECE453_DumptruckUltra_Board.xlsx, IMU.SchDoc, MCU.SchDoc, MCUDebug.SchDoc, MotorDrivers.SchDoc, PowerDistribution.SchDoc]
2023-03-08 Fixing revision mistakes
    [ECE453_DumptruckUltra_Board.xlsx, ServoDrivers.SchDoc, USB_to_UART.SchDoc]
2023-03-12 Added RGB debug LED to MCUDebug schematic and updated PCB
    [MCU.SchDoc, MCUDebug.SchDoc]
2023-03-12 Saved RGB LED changes
    [MCUDebug.SchDoc]
2023-03-15 starting motor routing
    [CustomFootprints.PcbLib, CustomSchematics.SchLib, MotorDrivers.SchDoc]
2023-03-17 Initial detection code on raspberry
2023-03-20 Servo Routing
    [ServoDrivers.SchDoc]
2023-03-20 Finished routing MCU signals for servos, motors, and MCU debug
    [DistanceSensor.SchDoc, ECE453_DumptruckUltra_Board.PrjPcb, IMU.SchDoc, MCU.SchDoc, MCUDebug.SchDoc, PowerDistribution.SchDoc]
2023-03-21 Routing for sensors and remaining components, excluding power
2023-03-21 some power routing
    [PowerDistribution.SchDoc]
2023-03-22 Added polygon routing
    [PowerDistribution.SchDoc]
2023-03-22 Final board pcb and rubric checks
    [ECE453_DumptruckUltra_Board.PrjPcb, UART.SchDoc, USB_to_UART.SchDoc]
2023-03-27 Finishing board revisions
2023-03-29 Software start (#5)
    * Starting project
    * Adding servo code
    * Settings
    * language changes?
    * removing projects
    * Adding submodules
    * trial run w/o submodules
    * Switching to VSCode
    * Adding testing logic, need to better guess the frequencies/duty cycle needed
    * Configured clangd, servos have scaled/limited PWM
    * Adding clangd help
    * cleanup test namespace
    * Removed testing from main
    * using more independent CY_TOOLS_PATHS rather than hardcoding
    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
2023-03-31 Bugfix/fix servo polarity (#6)
    * Testing change to invert polarity on the servo PWM signal
    * fixing servo alignment, resetting to main target
    * Fixing typo
    * Fixing test to make it more testable
    [Servo.cpp, test_Servo.cpp]
2023-03-31 Feature/motors (#7)
    * Motor implementation
    * finished the motors, passed hw testing
2023-04-03 Adding motor directions (#8)
2023-04-05 Feature/blinky (#11)
    * Creating a shared blinky task
    * intermediate teesting
    * Fixed blinky
    * fixing makefile
    [proc_setup.cpp, proc_setup.hpp, test_Blinky.cpp, test_freertos_isolated.cpp]
2023-04-07 Feature/i2c bus manager without FreeRTOS (#9)
    * Added some incomplete code for I2C bus manager
    * I2CBusManager without any FreeRTOS support
    * I2CBusManager seems to work alright (no FreeRTOS)
    * I2CBusManager without FreeRTOS works. Flashes LEDs on GPIO expander
    * Transferred test code to separate test file.
    * Update Software/DumptruckUltra-MCU/hw/i2c/i2cBusManager.cpp
    * Update Software/DumptruckUltra-MCU/hw/i2c/i2cBusManager.cpp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
2023-04-11 Feature/driving algorithm (#12)
    * Starting Driving Algorithm, getting definitions
    * Continuing driving algo impl
    * continuing drive alg implementation, need to keep converting Python code to C++
    * static
    * Up to completion condition
    * Finishing simple driving algorithm
    * Starting testing
    * Tests should work, on hold for now for hardware testing
    * Test works now. Needed to pause to let PWM do its thing
    * Finalizing driving algorithm for now, passes hw testing
    * Resetting Makefile
    * Fixing unused variable
    * Using more readable TICK conversion
    * More descriptive about the driving algorithm
    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
    [DeadReckoning.hpp, DrivingAlgorithm.cpp, DrivingAlgorithm.hpp, Motor.hpp, proc_setup.cpp, test_DrivingAlgorithm.cpp]
2023-04-14 Board updates to match actual boards
    [MainBoard.GBL, MainBoard.GBO, MainBoard.GBP, MainBoard.GBS, MainBoard.GTL, MainBoard.GTO, MainBoard.GTP, MainBoard.GTS]
2023-04-15 Re-layed out power supplies; need to fix reference layer
    [CustomSchematics.SchLib, DistanceSensor.SchDoc, IMU.SchDoc, MCU.SchDoc, MCUDebug.SchDoc, MotorDrivers.SchDoc, PowerDistribution.SchDoc, PressureSensor.SchDoc]
2023-04-15 Added more on reference layer, added vias to 6V power
2023-04-15 Intermediate board work
2023-04-15 Most things done, intermediate
    [Bill of Materials-ECE453_DumptruckUltra_Board.xls, CustomFootprints.PcbLib, CustomSchematics.SchLib, MCUDebug.SchDoc, MotorDrivers.SchDoc, PowerDistribution.SchDoc]
2023-04-17 Feature/imu (#14)
    * Added IMU files
    * Finding control registers from datasheet.
    * Added function definitions to header
    * Using hard fp; adding start of dead reckoning
    * Updates to header file
    * Fixing IMU names to be more descriptive
    * Creating DeadReckoning logic, starting tests
    * Added constants for register numbers and values
    * Adding more test, maybe we want full pose simulation to fully test this prior to integration
    * Added to IMU constructor
    * Continuing testing
    * Added function pointers to constructor for sending out data
    * Added retarget library
    * Updated imu.hpp and added IMU callback registering
    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
    [DeadReckoning.cpp, DeadReckoning.hpp, imu.cpp, imu.hpp, proc_setup.hpp, test_Blinky.cpp, test_DeadReckoning.cpp, test_getData.cpp]
2023-04-18 Fixing IMU on board, using breakout
    [CustomFootprints.PcbLib, CustomSchematics.SchLib, ECE453_DumptruckUltra_Board.PrjPcb, IMU.SchDoc]
2023-04-18 Revised board with mfg exports
    [MainBoard.GBL, MainBoard.GBO, MainBoard.GBP, MainBoard.GBS, MainBoard.GTL, MainBoard.GTO, MainBoard.GTP, MainBoard.GTS]
2023-04-18 Added distance sensor drivers and test (#13)
    * Added distance sensor drivers and test
    * Fixing C tooling, still build errors
    * In-progress fix
    * Fixing distance sensor. Weird behavior under power, also weird addressing scheme. Need to refactor in I2CBusManager @srao32
    * 1 and 2 byte register index versions added
    * test printing distance value to serial
    * Updates
    * re-re-setting Makefile
    ---------
    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
    [DistanceSensor.cpp, DistanceSensor.hpp, DistanceSensor_LibraryImpl.cpp, i2cBusManager.hpp, test_distance_sensor.cpp, test_i2cbus.cpp]
2023-04-19 Fixing IMU due to breaking I2C changes from the distance sensor (#16)
    [imu.cpp]
2023-04-22 RGB library (#19)
    * Starting RGB code
    * finishing RGB implementation
    * Resetting makefile
    [RGBLED.cpp, RGBLED.hpp]
2023-04-24 Feature/pressure sensor (#15)
    * added untested pressure sensor ADC code
    * Added pressure sensor stest
    * Check if sensor is pressed, naming convention changes
    * Remove iostream include, use 'printf' instead of 'cout'
    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
2023-04-24 Updated BOM
    [ECE453_DumptruckUltra_Board.xlsx]
2023-04-28 Adding servo sweep feature (#22)
2023-05-01 Feature/fsm (#25)
    * DOESN'T COMPILE: Added partial code to rea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
    [DeadReckoning.cpp, DeadReckoning.hpp, Dispenser.cpp, Dispenser.hpp, DistanceSensor.cpp, DistanceSensor.hpp]
2023-05-01 Feature/uart (#24)
    * Resolving hpp merge conflicts
    * Removed files that are possibly unique to Mac?
    * Update Software/DumptruckUltra-MCU/hw/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
2023-05-01 Arm (#21)
    * initial IK implementation
    * arduino arm
    * initial serial between arm and pi
    * default servo arm movement
    * pi-arduino uart communication of bounding boxes
    * Adding header interface for the arm control
    * Servo gradual movement implementation to goal position and then reset
    * inverse kinematics v2
    * ik equation updates
    * arm ik and movement code
    * removed unnecessary arm files and added additional arduino cod e for reference
    * arm test script
    * Final Arm Servo Code
    * arm hpp and cpp final updates
    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
    [Servo.hpp, Servo.ino, arm.cpp, arm.hpp, ik.cpp]
2023-05-01 I2CBusManager Mutual Exclusion (#23)
    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
2023-05-05 Feature/integration (#27)
    * fixing drive algorithm
    * updated ik angles
    * updated step size and bug fixes for arm
    * vision test script and edits to uart bytes
    * imu backwards?
    * driving test
    * motor testing for alignment/direction/sides
    * object detector + arm test
    * drive testing
    * arm updates and vision test
    * arm side-to-side movements
    * vision-uart latest tests
    * object test interr
    * Got vision UART working with the arm
    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
    [PowerDistribution.SchDoc, ServoDrivers.SchDoc]
